ParthSancheti/WingsOnHair/docs/images/mechanism.png

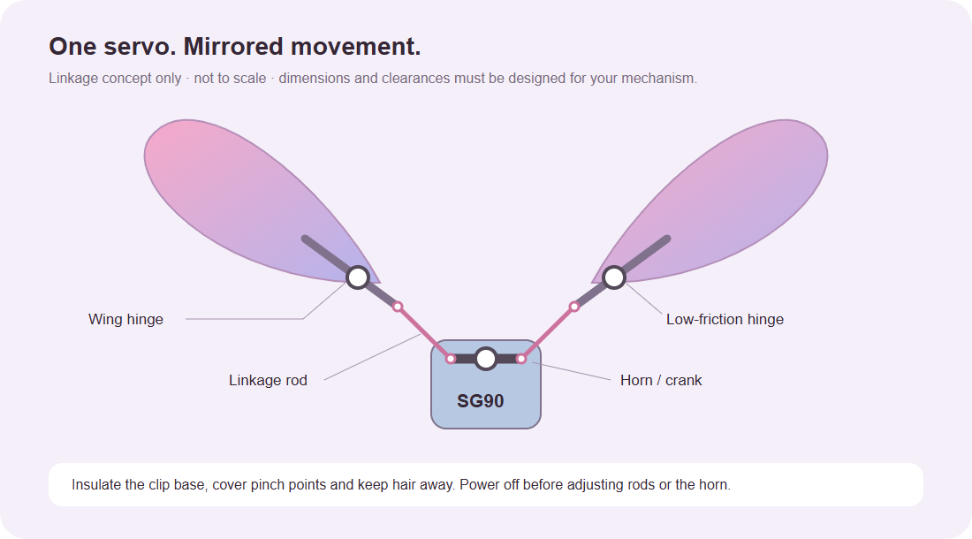
docs/images/mechanism.png
