ParthSancheti/WingsOnHair/docs/screenshots/simple-dark.png

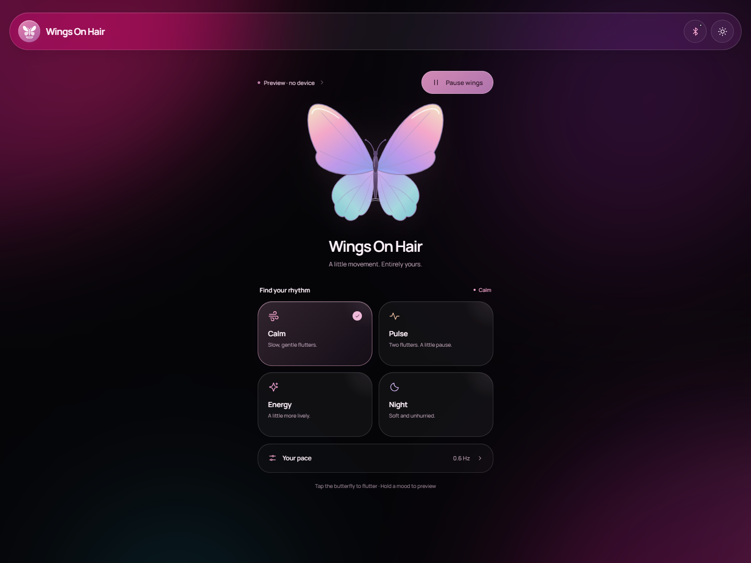
docs/screenshots/simple-dark.png
