ParthSancheti/WingsOnHair/docs/images/wiring.png

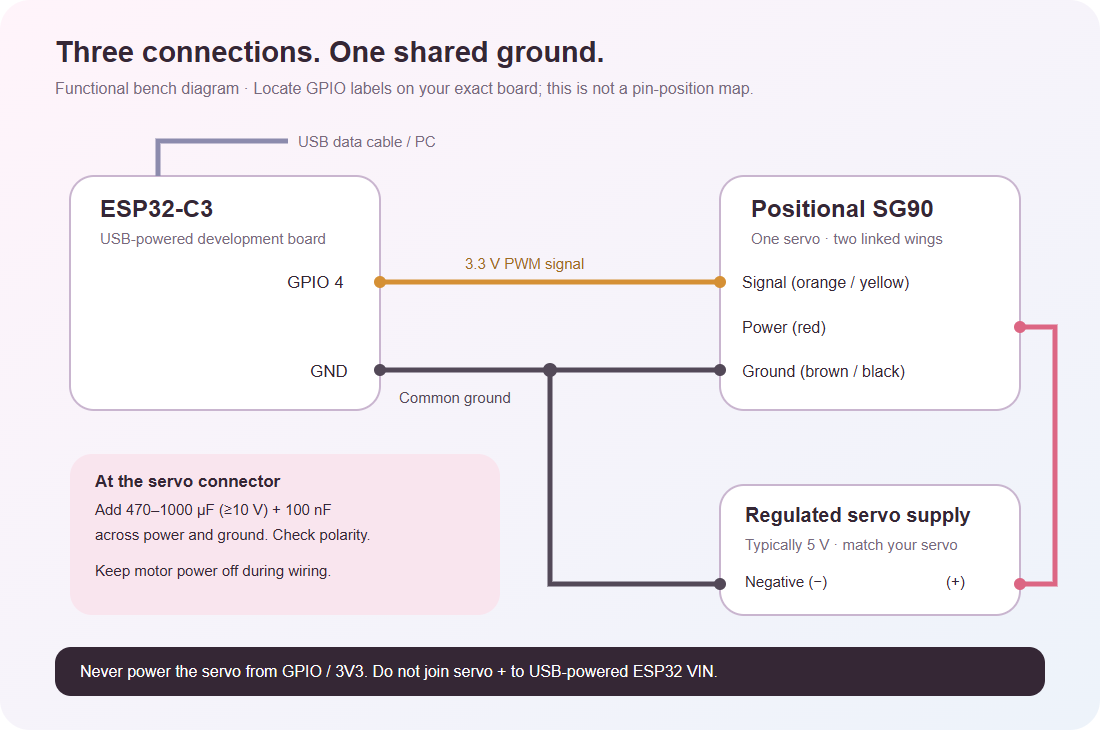
docs/images/wiring.png
