ParthSancheti/WingsOnHair/firmware/WingsOnHair_Firmware/ota_public_key.h

#pragma once
static constexpr char OTA_PUBLIC_KEY[] = R"KEY(-----BEGIN PUBLIC KEY-----
MFkwEwYHKoZIzj0CAQYIKoZIzj0DAQcDQgAE/3dVG/2koT7ipRHdTqDWEHl1wstP
6rI/E8y/0CpJsxKMGu9eEY7viZgrZ8A3WADngV8mxLKPSJBxR0CPqO+A7w==
-----END PUBLIC KEY-----
)KEY";
