ParthSancheti/WingsOnHair/(commit log)

2026-10-27 Build Wings On Hair 2.5 app, ESP32 firmware and illustrated builder guides
2026-11-03 Fix live touch and pause sync, add 150 mAh estimate and release alerts
    [WingsOnHair_Firmware.ino]
2026-11-04 Keep parking gentle and record calibration only after device confirmation
2026-11-04 Avoid replaying held touches and release PWM after a manual test flap
    [ManualControl.h, WingsOnHair_Firmware.ino]
2026-11-04 Support confirmed 45–113 degree wing travel across firmware and app
